adafruit/Adafruit-NeoSlider-PCB/Adafruit NeoSlider.brd

## EAGLE design Adafruit NeoSlider.brd (2021-12-03)

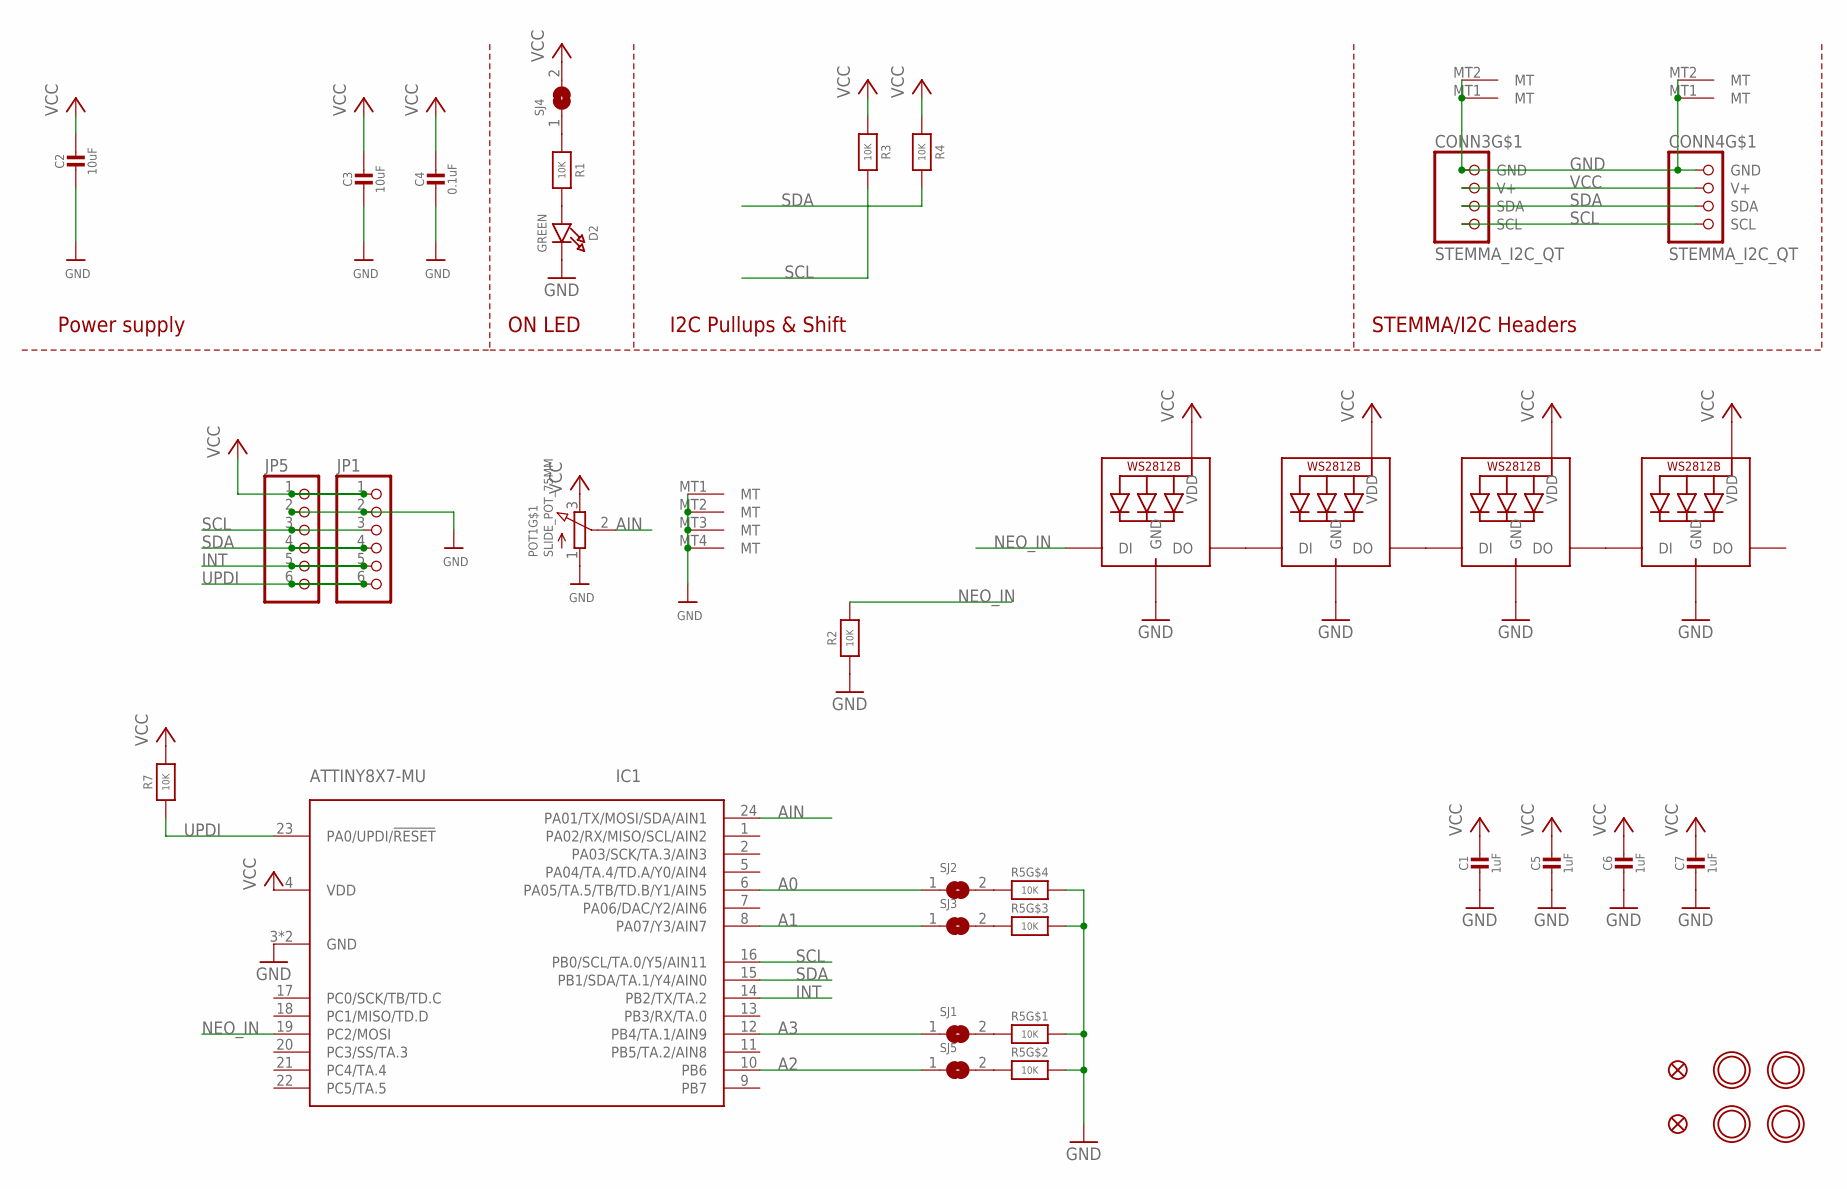
[picture p2: schematic Adafruit NeoSlider.sch]

Parts:
C1, C5, C6, C7: 1uF; 0603-NO
C2, C3: 10uF; 0805-NO
C4: 0.1uF; 0603-NO
CONN3, CONN4: STEMMA_I2C_QT; JST_SH4
D2: GREEN; CHIPLED_0603_NOOUTLINE
FID1, FID2: FIDUCIAL_1MM
IC1: ATTINY8X7-MU; QFN24_4MM
JP1, JP5: HEADER-1X670MIL; 1X06_ROUND_70
LED1, LED2, LED3, LED4: WS2812B_SK6812E; NEO3535_REVERSE
POT1: SLIDE_POT_75MM
R1, R2, R3, R4, R7: 10K; 0603-NO
R5: 10K; RESPACK_4X0603
SJ1, SJ2, SJ3, SJ4, SJ5: SOLDERJUMPERCLOSED; SOLDERJUMPER_CLOSEDWIRE
U$3, U$17, U$19, U$21: MOUNTINGHOLE2.5; MOUNTINGHOLE_2.5_PLATED

Connections:
A0: IC1.6 (PA05/TA.5/TB/TD.B/Y1/AIN5), SJ2.1
A1: IC1.8 (PA07/Y3/AIN7), SJ3.1
A2: IC1.10 (PB6), SJ5.1
A3: IC1.12 (PB4/TA.1/AIN9), SJ1.1
AIN: IC1.24 (PA01/TX/MOSI/SDA/AIN1), POT1.2 (S)
GND: C1.2, C2.2, C3.2, C4.2, C5.2, C6.2, C7.2, CONN3.1 (GND), CONN3.MT1 (MT), CONN3.MT2 (MT), CONN4.1 (GND), CONN4.MT1 (MT), CONN4.MT2 (MT), D2.C, IC1.3 (GND), IC1.THERM (GND), JP1.2, JP5.2, LED1.3-GND (GND), LED2.3-GND (GND), LED3.3-GND (GND), LED4.3-GND (GND), POT1.1 (A), POT1.MT1 (MT), POT1.MT2 (MT), POT1.MT3 (MT), POT1.MT4 (MT), R2.1, R5.5 (2), R5.6 (2), R5.7 (2), R5.8 (2)
INT: IC1.14 (PB2/TX/TA.2), JP1.5, JP5.5
unnamed: D2.A, R1.2
unnamed: LED1.2-DOUT (DO), LED2.4-DIN (DI)
unnamed: LED2.2-DOUT (DO), LED3.4-DIN (DI)
unnamed: LED3.2-DOUT (DO), LED4.4-DIN (DI)
unnamed: R5.1, SJ1.2
unnamed: R5.2 (1), SJ5.2
unnamed: R5.3 (1), SJ3.2
unnamed: R5.4 (1), SJ2.2
unnamed: R1.1, SJ4.1
NEO_IN: IC1.19 (PC2/MOSI), LED1.4-DIN (DI), R2.2
SCL: CONN3.4 (SCL), CONN4.4 (SCL), IC1.16 (PB0/SCL/TA.0/Y5/AIN11), JP1.3, JP5.3, R3.2
SDA: CONN3.3 (SDA), CONN4.3 (SDA), IC1.15 (PB1/SDA/TA.1/Y4/AIN0), JP1.4, JP5.4, R4.2
UPDI: IC1.23 (PA0/UPDI/!RESET), JP1.6, JP5.6, R7.1
VCC: C1.1, C2.1, C3.1, C4.1, C5.1, C6.1, C7.1, CONN3.2 (V+), CONN4.2 (V+), IC1.4 (VDD), JP1.1, JP5.1, LED1.1-VDD (VDD), LED2.1-VDD (VDD), LED3.1-VDD (VDD), LED4.1-VDD (VDD), POT1.3 (E), R3.1, R4.1, R7.2, SJ4.2

Notes on the sheet:
I2C Pullups & Shift
STEMMA/I2C Headers
ON LED
Power supply

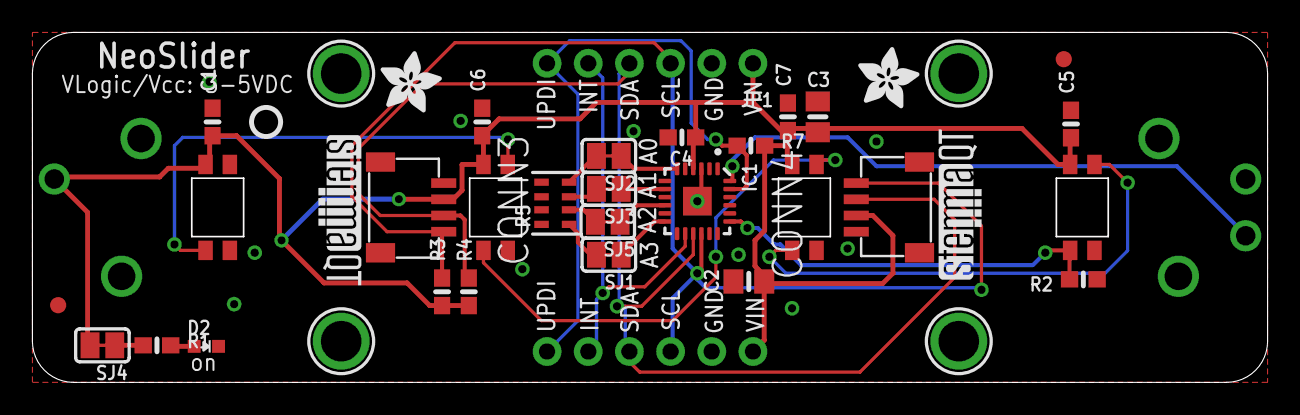
[picture p3: board Adafruit NeoSlider.brd from above]

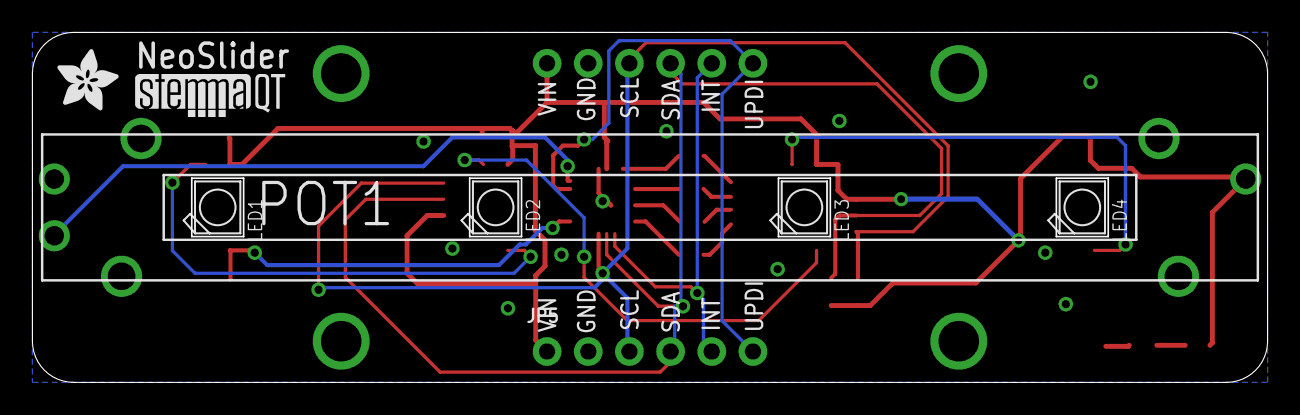
[picture p4: board Adafruit NeoSlider.brd from below]

Board: 2 copper layers, 76.2 x 21.6 mm, 42 parts (8 on the bottom side), 21 nets.

Other parts of the board:
U$1, U$2, U$9: ADAFRUIT_3.5MM
U$7, U$30, U$31: STEMMAQT
U$25: PCBFEAT-REV-040
